gyurika12/smart-city-poles/docs/images/ha-pole2.jpg

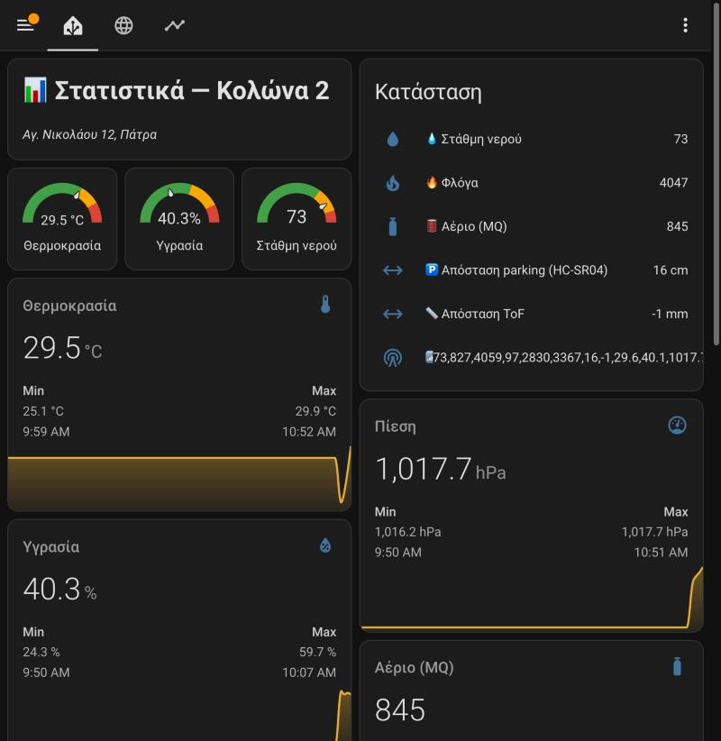
docs/images/ha-pole2.jpg
