gyurika12/smart-city-poles/(commit log)

2026-10-09 Smart city street-light poles — diploma thesis
    Firmware for three ESP32-S3 poles + camera, shared KolonaCore library,
    Home Assistant automation/energy experiment, docs and photos.
    Bilingual README (English / Greek).
2026-10-09 Add Grafana dashboard, InfluxDB config; HTML dashboard without stored token
    - grafana/: importable dashboard (29 panels) + generator script, screenshot
    - home_assistant/influxdb.yaml: integration config (password via !secret)
    - dashboard_kolones.html now uses the current HA login instead of a
    hard-coded long-lived token (tools/patch_ha_token.py)
2026-10-09 COL1 pressure: document Pa->hPa conversion in Home Assistant; update screenshot
2026-10-09 COL1: fix LTR390 UV index scaling (gain 3x/18-bit), report -1 when sensor missing
    [col1.ino]
2026-10-09 COL1: I2C bus scan at boot, LTR390 support for DFRobot (0x1C) and plain (0x53) modules, BH1750 0x5C fallback
2026-10-09 Grafana: pressure panels keep only 900-1100 hPa so the axis auto-scales; 1 decimal
2026-10-14 Add-on 2.0.0: any number of poles, config-driven dashboard
    - New `poles` list option replaces the fixed light/presence_pole_1..3;
    the automation, helpers, energy package, watchdog and dashboard are all
    generated from it (smart-poles-render, bash + jq, testable in CI)
    - Options for brightness levels, hold time, lux thresholds and scenario
    (adaptive / baseline / alternate); options are validated before install
    - Dashboard reads config.json, discovers each pole's sensors from the
    presence sensor's device + entity_match tokens, shows lamp state and
    offline poles, optional demo poles, mobile topbar fix
    - nginx: fix /api proxy path, expose only the endpoints the dashboard
    needs, accept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
